VEC01773/WS2813-7segPanel/WS2813-7seg回路図.pdf

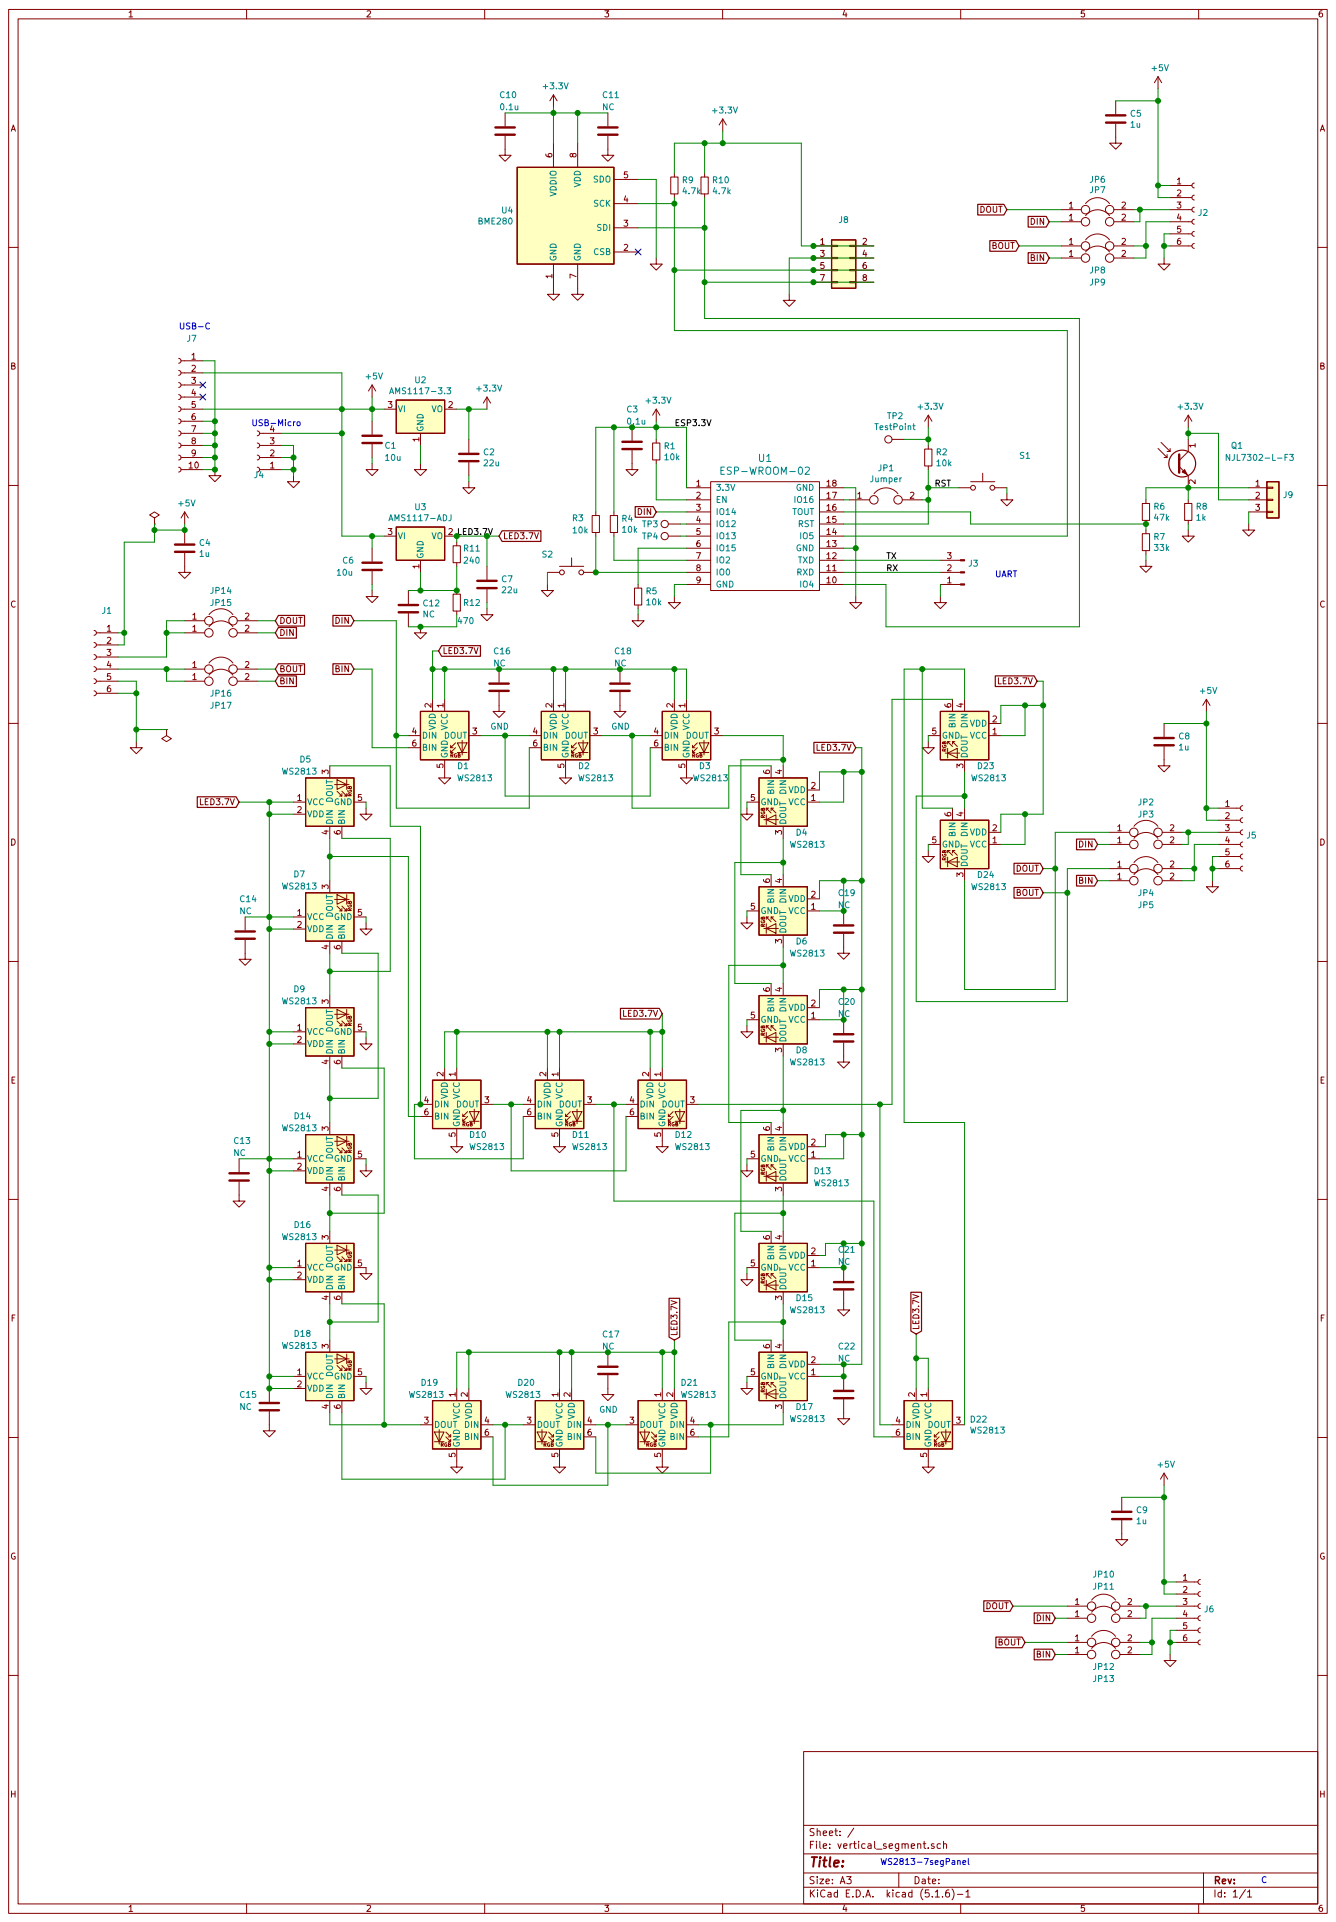
[picture p7: page 1]

1 CSB 2 SDI 3 SCK 4 SDO 5 VDDIO

6 D23 WS2813 RGB VCC 1 VDD 2 DOUT

6 D6 WS2813 RGB VCC 1 VDD 2 DOUT

6 D14 WS2813 RGB VCC 1 VDD 2 DOUT

6 D13 WS2813 RGB VCC 1 VDD 2 DOUT

6 D18 WS2813 RGB VCC 1 VDD 2 DOUT

6 D17 WS2813 RGB VCC 1 VDD 2 DOUT

5 BIN 6 D20 WS2813 RGB VCC 1 VDD 2 DOUT

5 BIN 6 D19 WS2813 RGB VCC 1 VDD 2 DOUT
