VEC01773/WS2813-7segPanel/(commit log)

2020-12-06 新規作成
2020-12-15 外部の明るさ取得
2020-12-18 サンプル追加
2020-12-18 Clockサンプルコメント追加
2020-12-19 Moisture Sample
2020-12-30 TempHumidityサンプル追加
2021-01-02 不快指数で色制御
2021-01-02 明るさステップ修正
2021-01-02 コメント
2021-01-04 AlexaDiceサンプル追加
2021-01-09 アレクササイコロコメント追加
2021-01-11 サンプル見直し
2021-03-13 DispLEDIndex追加
2021-04-18 フォルダ変更
2021-04-18 フォルダ移動
2021-04-22 'd'追加
2021-04-29 sample見直し
